rlankenau/thotcon0x6/README.md

thotcon0x6
==========

Thotcon 0x6 badge stuff.
