rlankenau/thotcon0x6/art/thotcon0x6.bmp

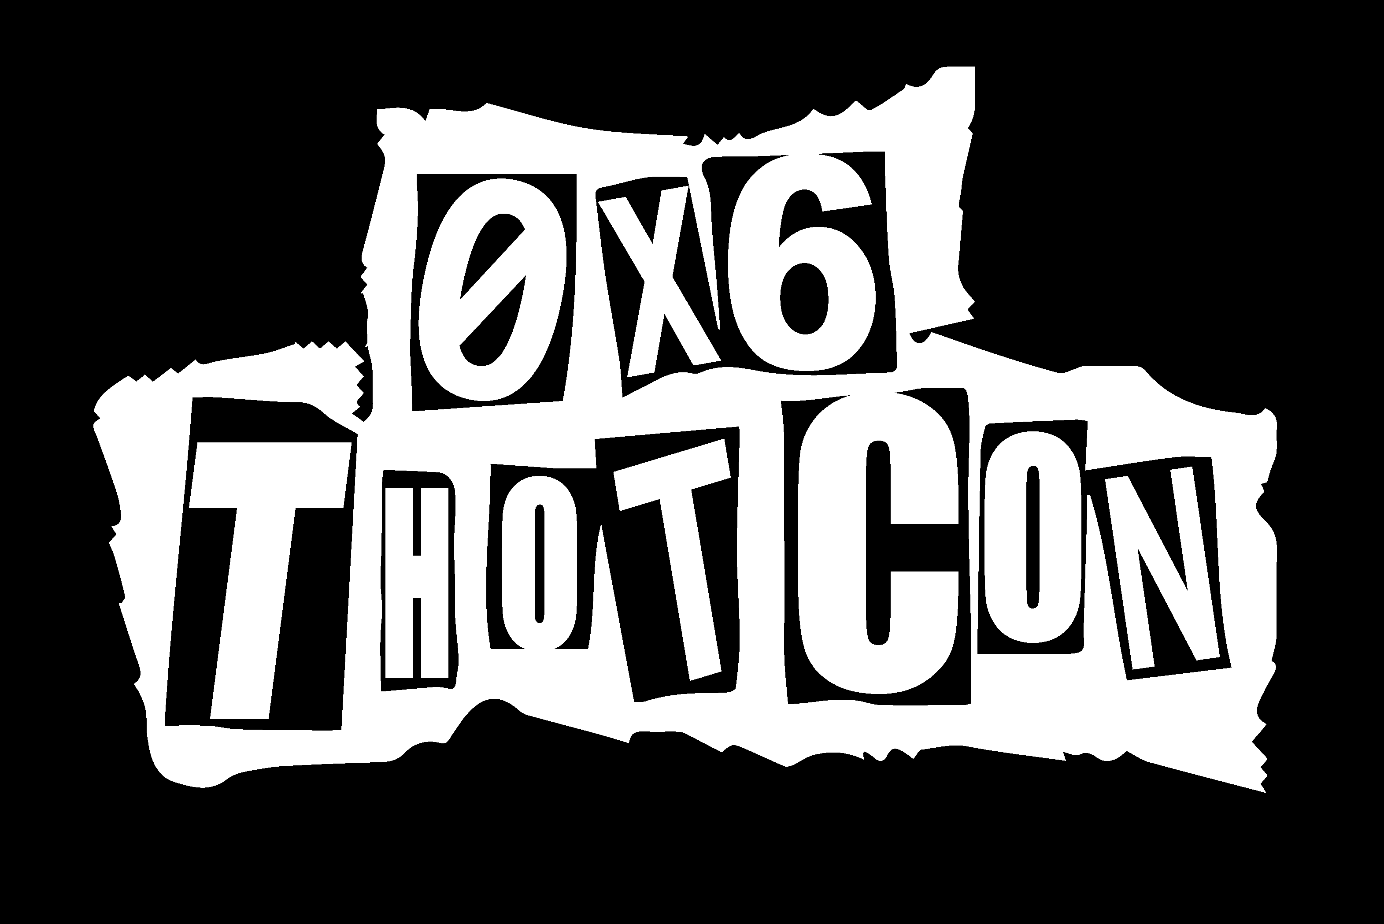
art/thotcon0x6.bmp
