rlankenau/thotcon0x6/art/THOTCON_0x6 - Torn Letter.bmp

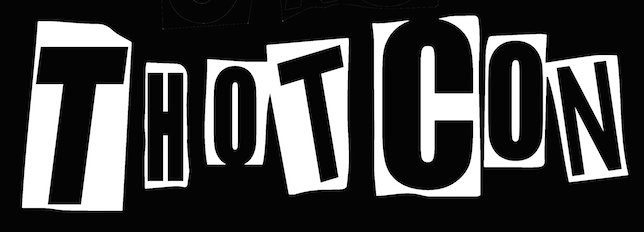
art/THOTCON_0x6 - Torn Letter.bmp
