rlankenau/thotcon0x6/hardware/schematics/temp.png

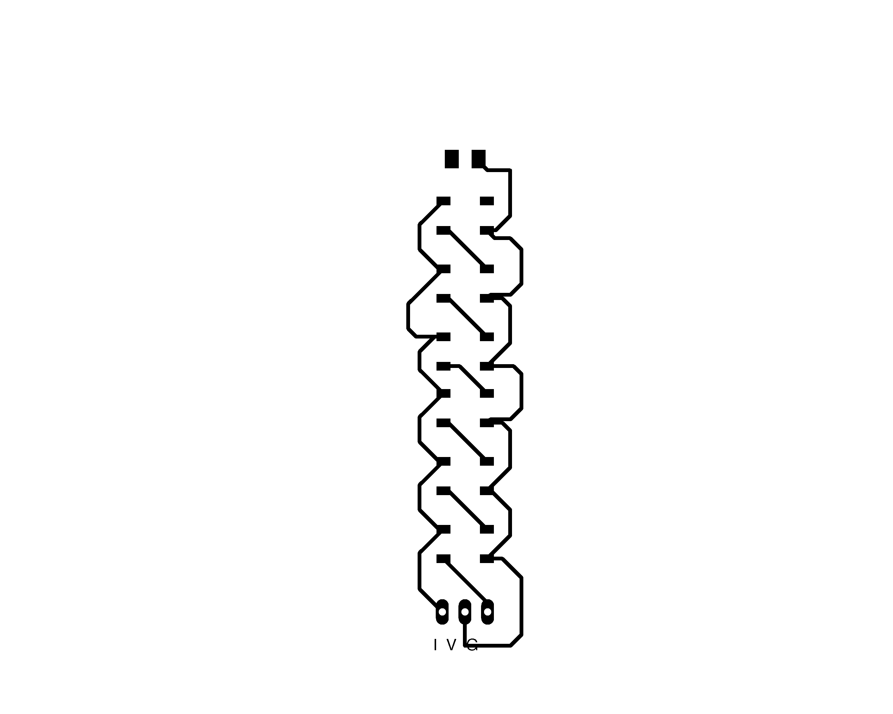
hardware/schematics/temp.png
