rlankenau/thotcon0x6/hardware/stencil/stencil.png

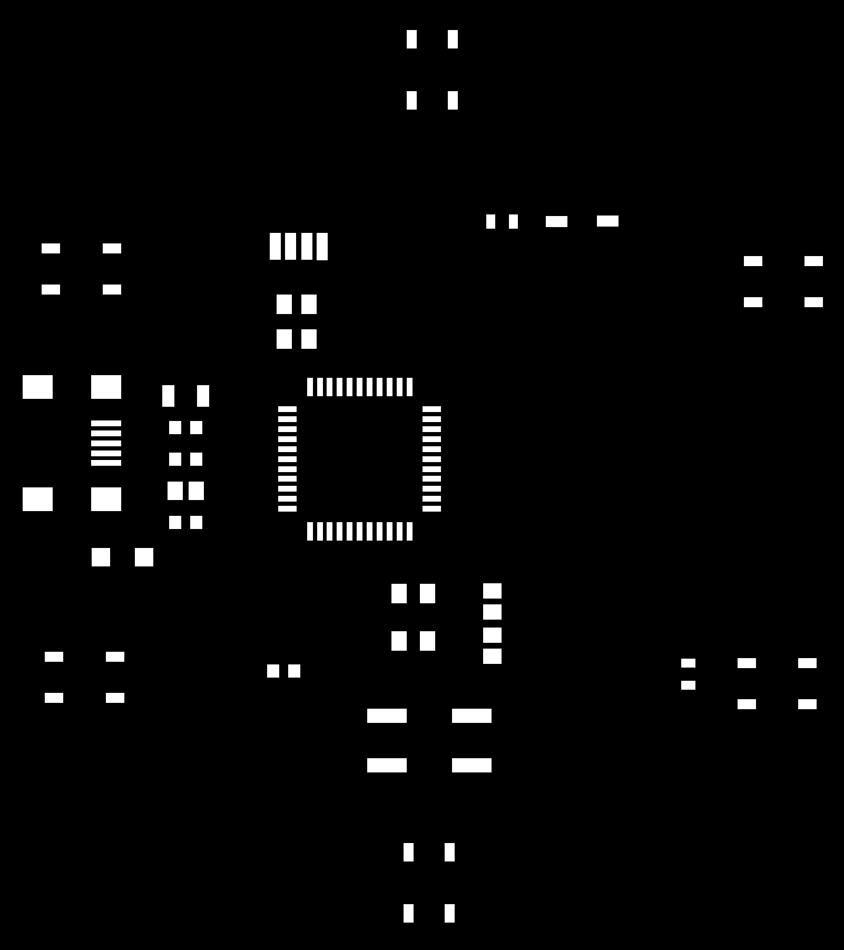
hardware/stencil/stencil.png
