rlankenau/thotcon0x6/hardware/tc-proto.png

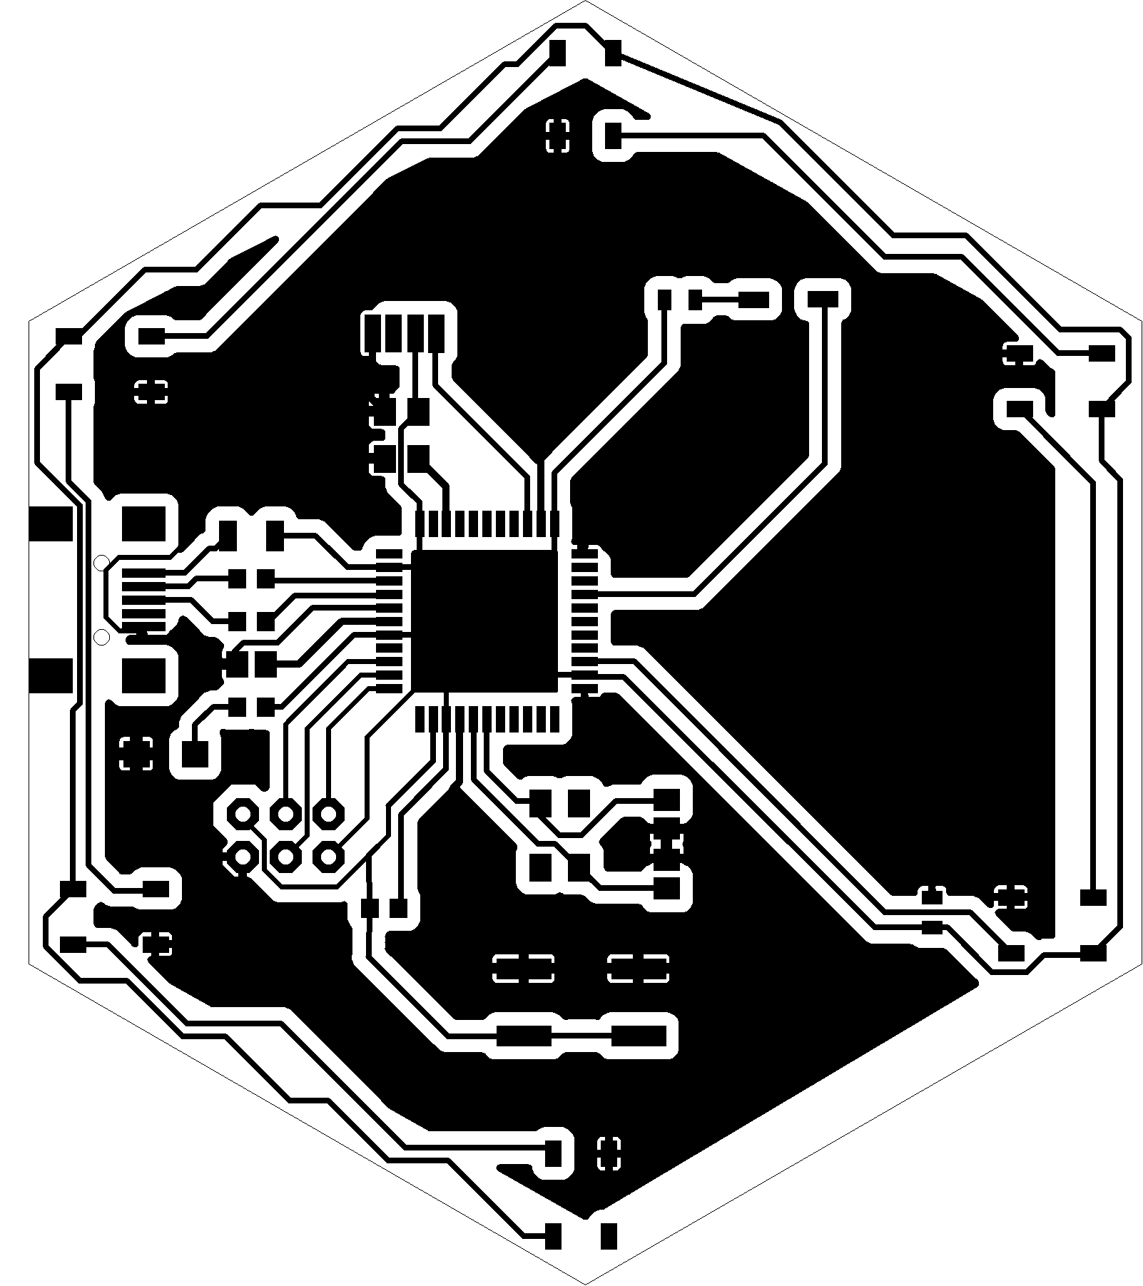
hardware/tc-proto.png
