rlankenau/thotcon0x6/BoM/THOTCON-0x6-PROTO-BoM.xls

THOTCON0x6-PROTO
Supplier SKU# | Mfr. # | Manufacturer | Desc. | RoHS | Lifecycle | Customer Part # | Order Qty. | Price (USD)
720-LGN971-KN-1 | LG N971-KN-1 | Osram Opto Semiconductor | Standard LEDs - SMD Green, 570nm 45mcd, 20mA | RoHS Compliant |  |  | 1 | $0.09
667-EVQ-Q2P02W | EVQ-Q2P02W | Panasonic | Tactile Switches 1.6NF 6.5x6.0x2.5mm | RoHS Compliant |  |  | 1 | $0.273
712-BAT-HLD-001-THM | BAT-HLD-001-THM | Linx Technologies | Coin Cell Battery Holders Bat Hld CR2032/2025 Through-hole Mount | RoHS Compliant |  |  | 1 | $0.28
576-1206L050/15YR | 1206L050/15YR | Littelfuse | Resettable Fuses - PPTC 15V 1206 .500A POLYFUSE | RoHS Compliant |  |  | 1 | $0.381
538-67503-1020 | 67503-1020 | Molex | USB Connectors USB Mini-B Recept On-The-Go Rt.Angle | RoHS Compliant |  |  | 1 | $0.992
594-MCT06030C2209FP5 | MCT06030C2209FP500 | Vishay | Thin Film Resistors - SMD .1W 22ohm 1% 0603 50ppm Auto | RoHS Compliant | New At Mouser |  | 2 | $0.06
71-CRCW0603-10K-E3 | CRCW060310K0FKEA | Vishay | Thick Film Resistors - SMD 1/10watt 10Kohms 1% | RoHS Compliant By Exemption |  |  | 1 | $0.013
78-TSML1020 | TSML1020 | Vishay | Infrared Emitters 12 Degree 190mW | RoHS Compliant |  |  | 1 | $0.60
140-VE100M1CTR0405 | VE-100M1CTR-0405 | Lelon | Aluminum Electrolytic Capacitors - SMD 16 Volts 10uF 20% 4x5.3 | RoHS Compliant |  |  | 1 | $0.12
81-GRM219R61H105KA3D | GRM219R61H105KA73D | Murata | Multilayer Ceramic Capacitors MLCC - SMD/SMT 0805 1uF 50volts X5R 10% | RoHS Compliant | New Product |  | 1 | $0.10
77-VJ0805Y104MXXAC | VJ0805Y104MXXAC | Vishay | Multilayer Ceramic Capacitors MLCC - SMD/SMT .1uF 25volts X7R 20% | RoHS Compliant |  |  | 4 | $0.06
556-ATMEGA32U4-AU | ATMEGA32U4-AU | Atmel | 8-bit Microcontrollers - MCU AVR USB 32K FLASH INDUSTRIAL | RoHS Compliant |  |  | 1 | $5.74
77-VJ0805A180GXXCBC | VJ0805A180GXXCW1BC | Vishay | Multilayer Ceramic Capacitors MLCC - SMD/SMT 0805 18pF 25volts C0G 2% | RoHS Compliant |  |  | 2 | $0.06
782-TSOP36236TT | TSOP36236TT | Vishay | Infrared Receivers 2.7-5.5V 36kHz 45Deg | RoHS Compliant |  |  | 1 | $1.48
ADA-1655 | WS2128B | Worldsemi | Intelligent Control LED Integrated Light Source | RoHS Compliant |  |  | 6 | $0.45
