rlankenau/thotcon0x6/art/hexagon.dxf

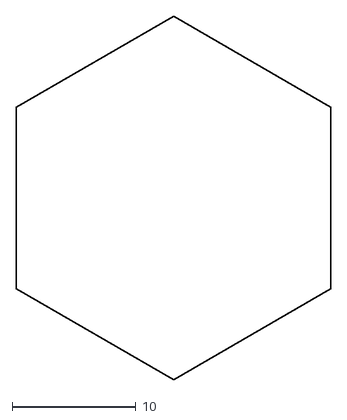
[picture p6: CAD file, 2015-03-03]
art/hexagon.dxf
25.4 x 29.3
