rlankenau/thotcon0x6/hardware/hexagon.dxf

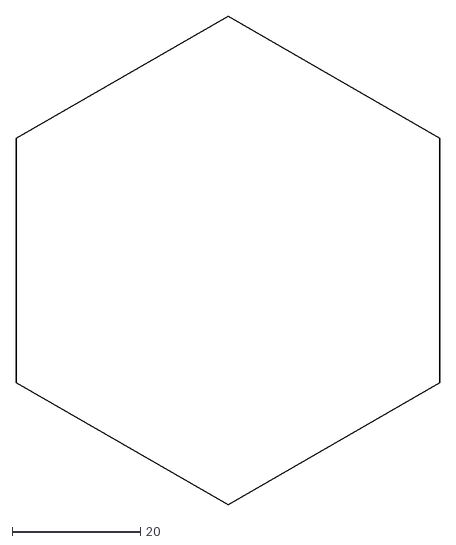
[picture p7: CAD file, 2015-03-09]
hardware/hexagon.dxf
66.0 x 76.2
