rlankenau/thotcon0x6/hardware/hexagon.scad

$fn = 150 ;			// OpenSCAD Resolution


projection(cut = true) Hexagon(cle=25.4,h=1);


module Hexagon(cle,h)
{
	angle = 360/6;		// 6 pans
	cote = cle * cot(angle);
	echo(angle, cot(angle), cote);
	echo(acos(.6));

	union()
	{
		rotate([0,0,0])
			cube([cle,cote,h],center=true);
		rotate([0,0,angle])
			cube([cle,cote,h],center=true);
		rotate([0,0,2*angle])
			cube([cle,cote,h],center=true);
	}


}


function cot(x)=1/tan(x);

//==EOF=======================================================
