rlankenau/thotcon0x6/hardware/tc0x6proto1.pdf

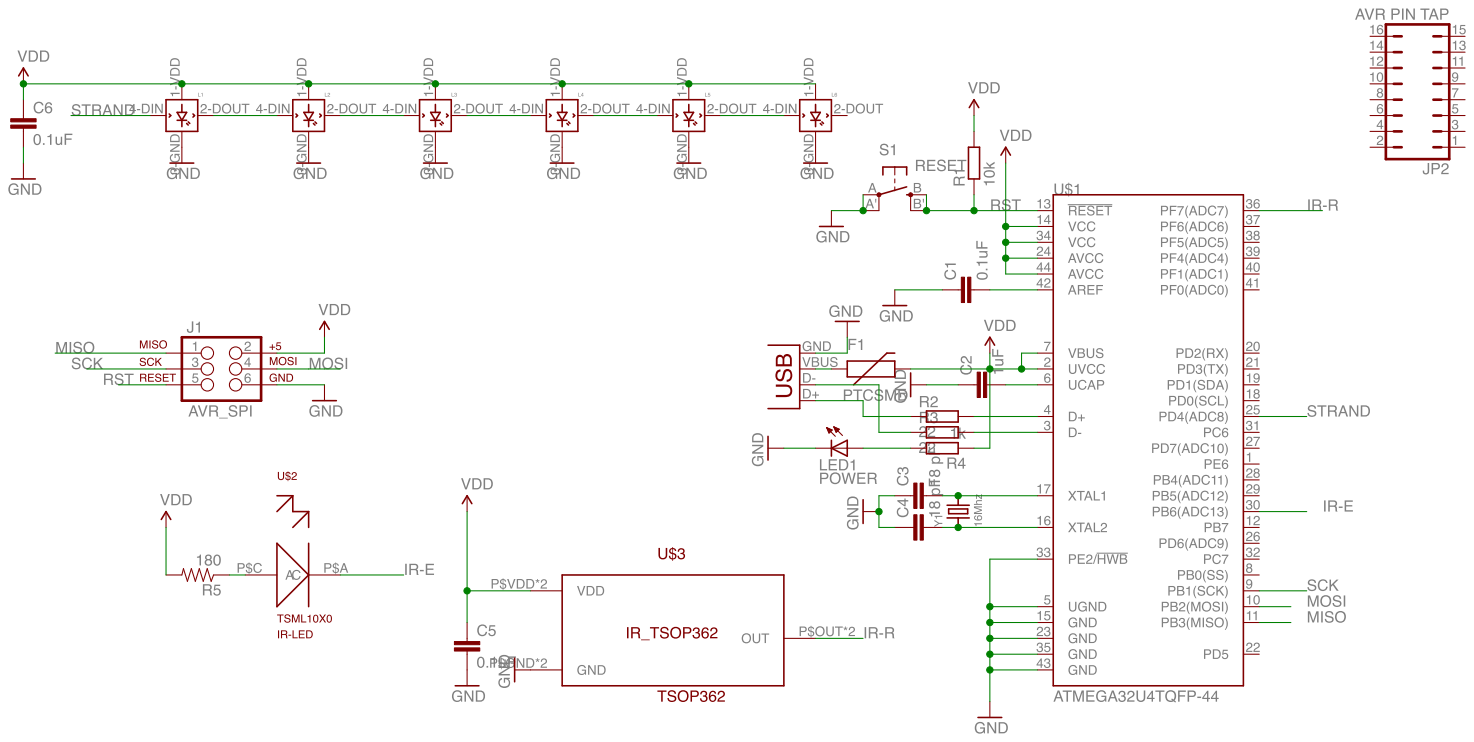
[picture p8: page 1]
