rlankenau/thotcon0x6/hardware/schematics/tc0x6proto1.brd

## EAGLE design hardware/schematics/tc0x6proto1.brd (2015-04-30)

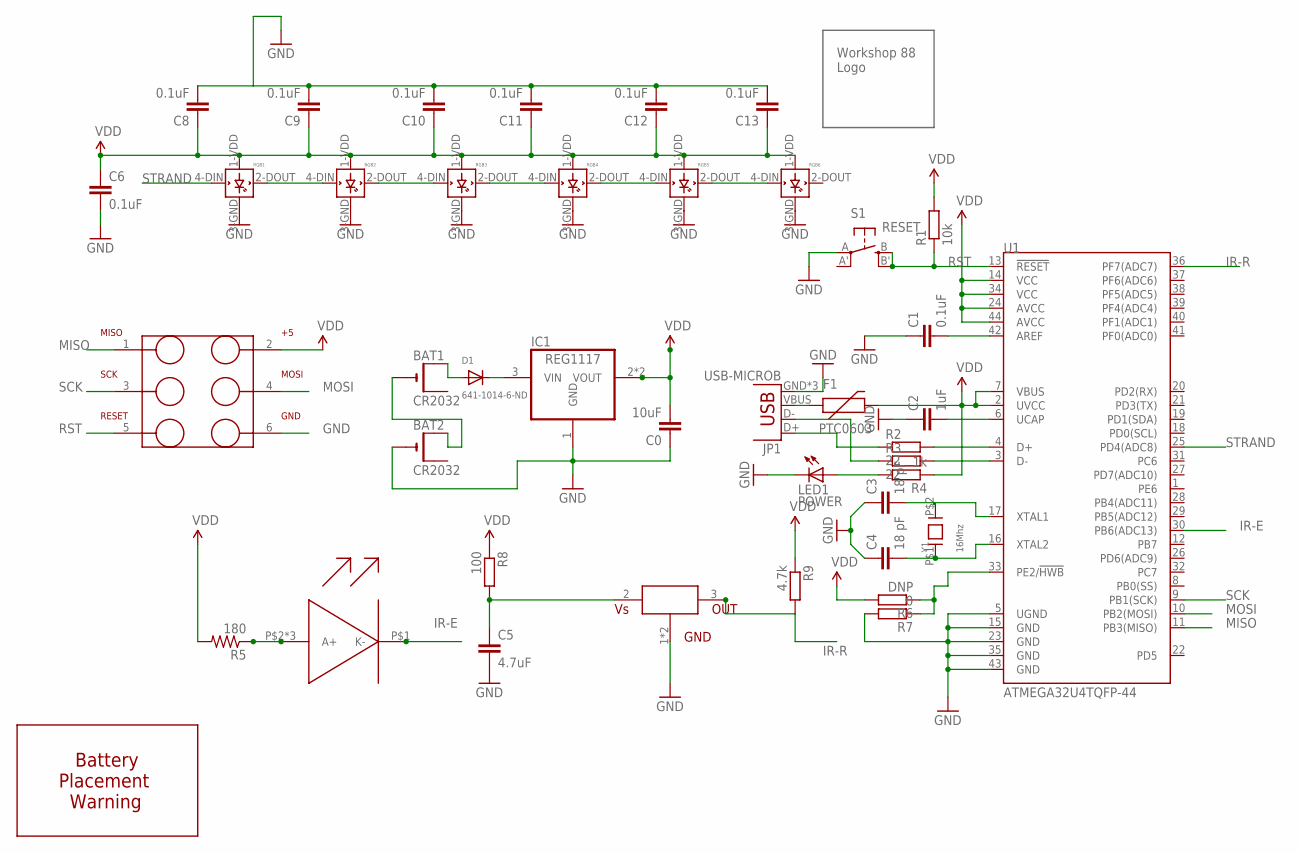
[picture p9: schematic tc0x6proto1.sch, THOTCON 0x6 Prototype]

Parts:
BAT1, BAT2: CR2032; CR2032-SMD
C0: 10uF; C0603
C1, C8, C9, C10, C11, C12, C13: 0.1uF; C0603
C2: 1uF; C0603
C3, C4: 18 pF; C0603
C5: 4.7uF; C0603
C6: 0.1uF; 0603-CAP
D1: 641-1014-6-ND; SMADIODE
F1: PTC0603; 0603
IC1: REG1117; SOT223
JP1: USB-MICROB
LED1: POWER; CHIPLED_1206
R1: 10k; R0603
R2, R3: 22; R0603
R4: 1k; R0603
R5: 180; 0603-RES
R6: DNP; R0603
R7: 0; R0603
R8: 100; R0603
R9: 4.7k; R0603
RGB1, RGB2, RGB3, RGB4, RGB5, RGB6: WS2812B
S1: RESET; EVQ-Q2
U1: ATMEGA32U4TQFP-44; TQFP44
U2: TSMP77000; TSMP77000TT
U3: SFH4259S; POWER_TOPLED_WITH_LENS
U$1: W88LOGO; W88-LOGO
U$4: AVR-TAG-CONNECTSNAP-ON; TC2030-MCP
U$5: BATTERY_WARNING; BATTERY_PLACEMENT_WARN
Y1: 16Mhz; SMD5MMX3.2MM

Connections:
BAT_BAT: BAT1.-, BAT2.+$1 (+)
GND: BAT2.-, C0.1, C1.1, C2.1, C3.1, C4.1, C5.2, C6.2, C8.2, C9.2, C10.2, C11.2, C12.2, C13.2, IC1.1 (GND), JP1.GND, JP1.MT1 (GND), JP1.MT2 (GND), LED1.C, R7.2, RGB1.3-GND (GND), RGB2.3-GND (GND), RGB3.3-GND (GND), RGB4.3-GND (GND), RGB5.3-GND (GND), RGB6.3-GND (GND), S1.A, U1.5 (UGND), U1.15 (GND), U1.23 (GND), U1.35 (GND), U1.43 (GND), U2.1 (GND), U2.4 (GND), U$4.6 (GND)
IR-E: U1.30 (PB6(ADC13)), U3.P$1 (K-)
IR-R: R9.2, U1.36 (PF7(ADC7)), U2.3 (OUT)
MISO: U1.11 (PB3(MISO)), U$4.1 (MISO)
MOSI: U1.10 (PB2(MOSI)), U$4.4 (MOSI)
unnamed: C5.1, R8.2, U2.2 (VDD)
unnamed: R3.2, U1.3 (D-)
unnamed: R6.1, R7.1, U1.33 (PE2/!HWB)
unnamed: JP1.D+, R2.1
unnamed: C1.2, U1.42 (AREF)
unnamed: R2.2, U1.4 (D+)
unnamed: JP1.D-, R3.1
unnamed: LED1.A, R4.2
unnamed: C2.2, U1.6 (UCAP)
unnamed: C3.2, U1.17 (XTAL1), Y1.P$2 (2)
unnamed: C4.2, U1.16 (XTAL2), Y1.P$1 (1)
unnamed: R5.1, U3.P$2 (A+), U3.P$3 (A+), U3.P$4 (A+)
unnamed: F1.1, JP1.VBUS
RST: R1.1, S1.B (S), S1.B' (S1), U1.13 (!RESET), U$4.5 (RESET)
SCK: U1.9 (PB1(SCK)), U$4.3 (SCK)
STRAND: RGB1.4-DIN (DIN), U1.25 (PD4(ADC8))
STRAND_1_2: RGB1.2-DOUT (DOUT), RGB2.4-DIN (DIN)
STRAND_2_3: RGB2.2-DOUT (DOUT), RGB3.4-DIN (DIN)
STRAND_3_4: RGB3.2-DOUT (DOUT), RGB4.4-DIN (DIN)
STRAND_4_5: RGB4.2-DOUT (DOUT), RGB5.4-DIN (DIN)
STRAND_5_6: RGB5.2-DOUT (DOUT), RGB6.4-DIN (DIN)
VBAT: BAT1.+$1 (+), D1.A
VBAT_RECT: D1.C, IC1.3 (VIN)
VDD: C0.2, C6.1, C8.1, C9.1, C10.1, C11.1, C12.1, C13.1, F1.2, IC1.2 (VOUT), IC1.4 (VOUT), R1.2, R4.1, R5.2, R6.2, R8.1, R9.1, RGB1.1-VDD (VDD), RGB2.1-VDD (VDD), RGB3.1-VDD (VDD), RGB4.1-VDD (VDD), RGB5.1-VDD (VDD), RGB6.1-VDD (VDD), U1.2 (UVCC), U1.7 (VBUS), U1.14 (VCC), U1.24 (AVCC), U1.34 (VCC), U1.44 (AVCC), U$4.2 (VCC)

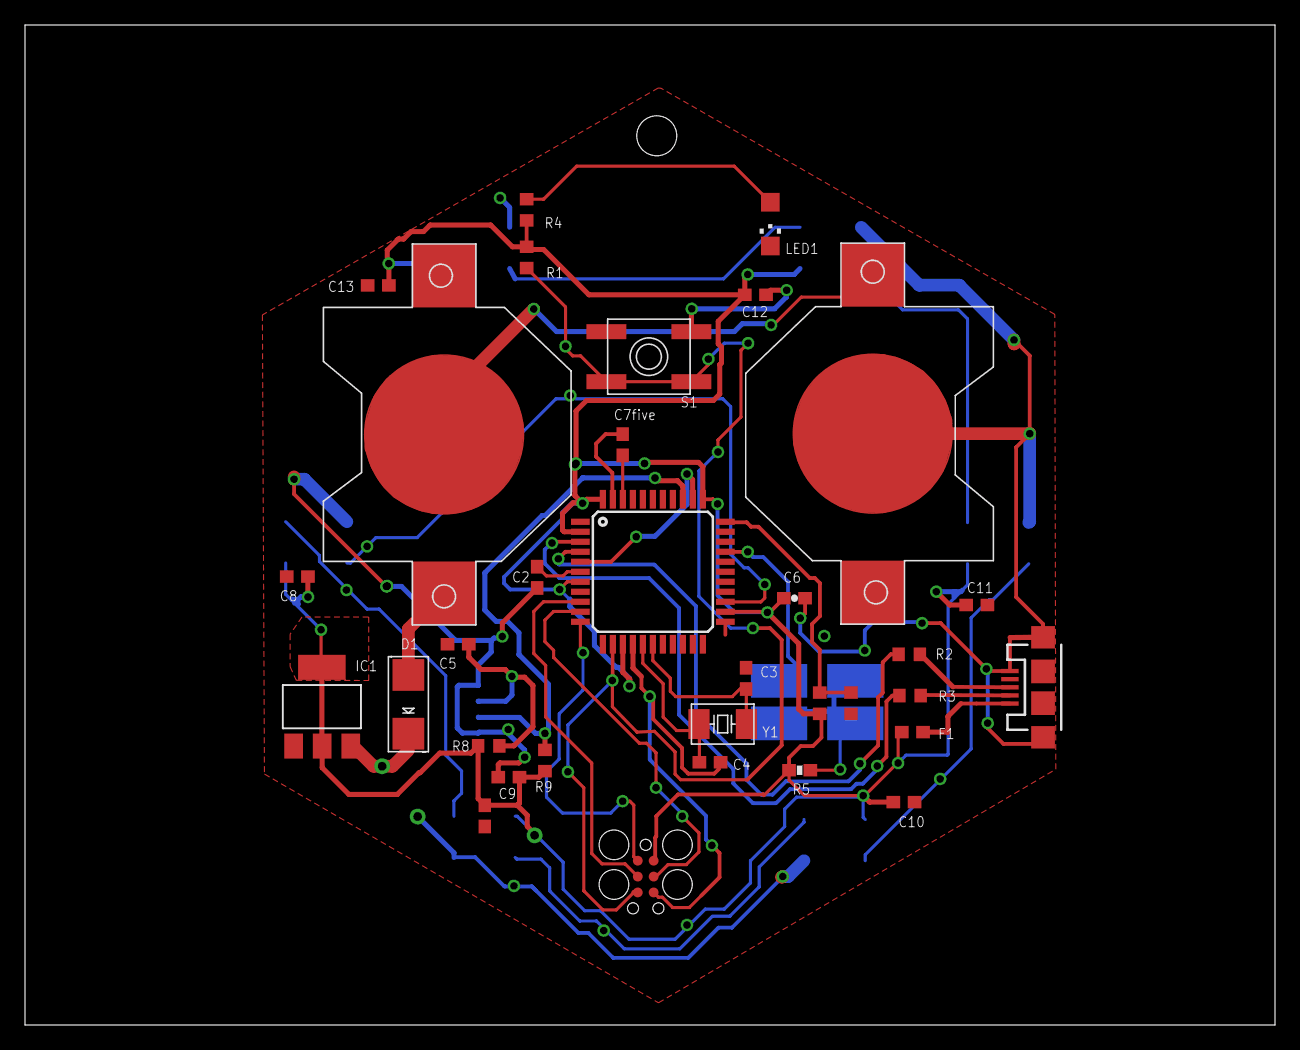
[picture p10: board hardware/schematics/tc0x6proto1.brd from above]

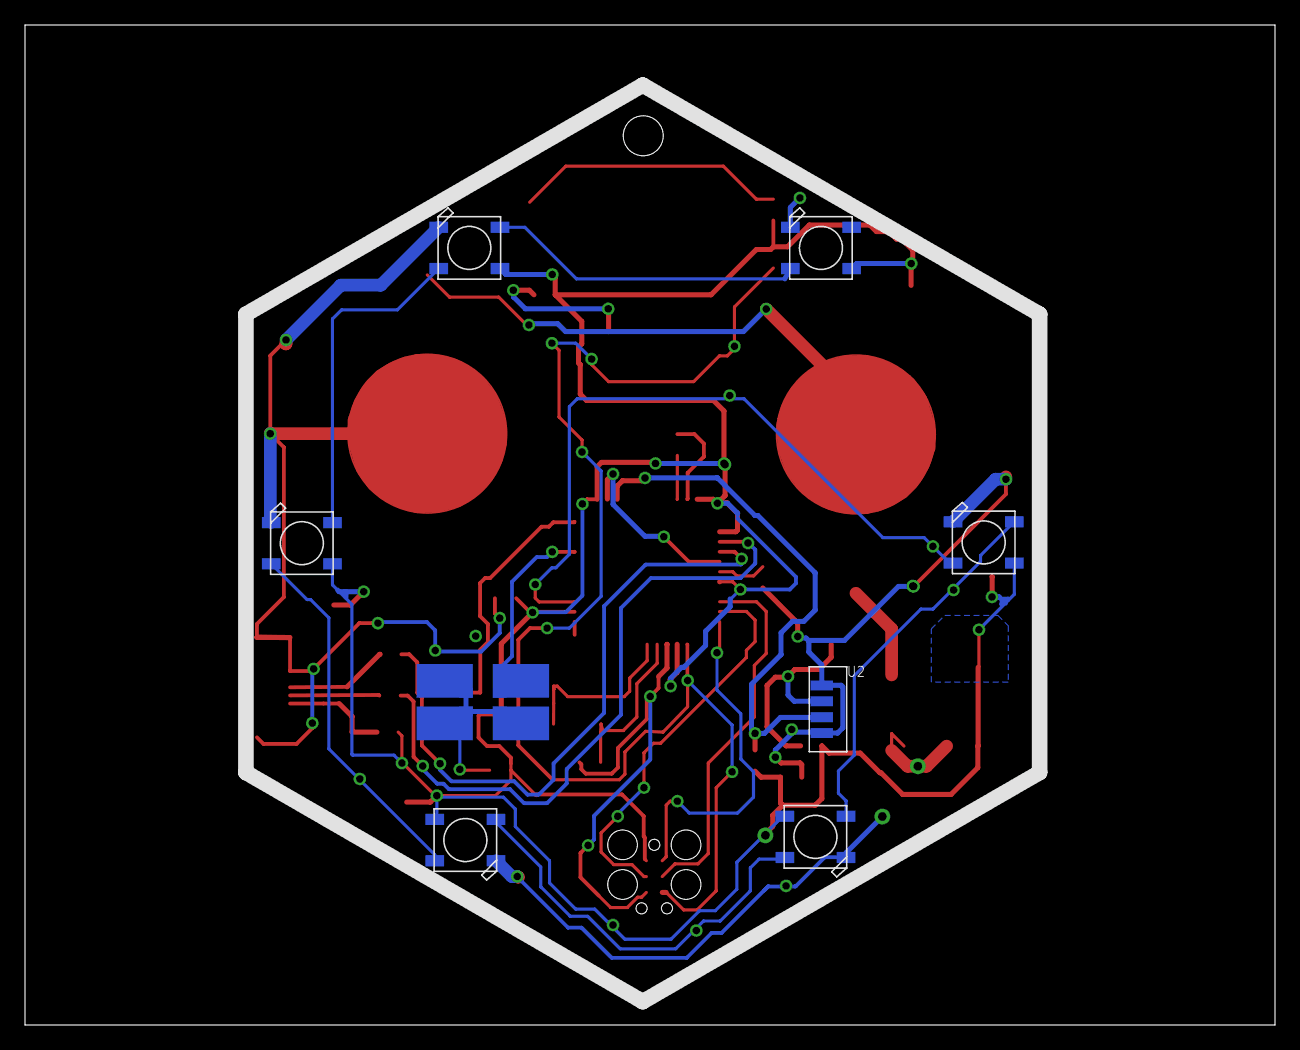
[picture p11: board hardware/schematics/tc0x6proto1.brd from below]

Board: 2 copper layers, 100.0 x 80.0 mm, 43 parts (8 on the bottom side), 30 nets.
