rlankenau/thotcon0x6/hardware/boards/tc0x6breakout.brd

## EAGLE design hardware/boards/tc0x6breakout.brd (2015-03-09)

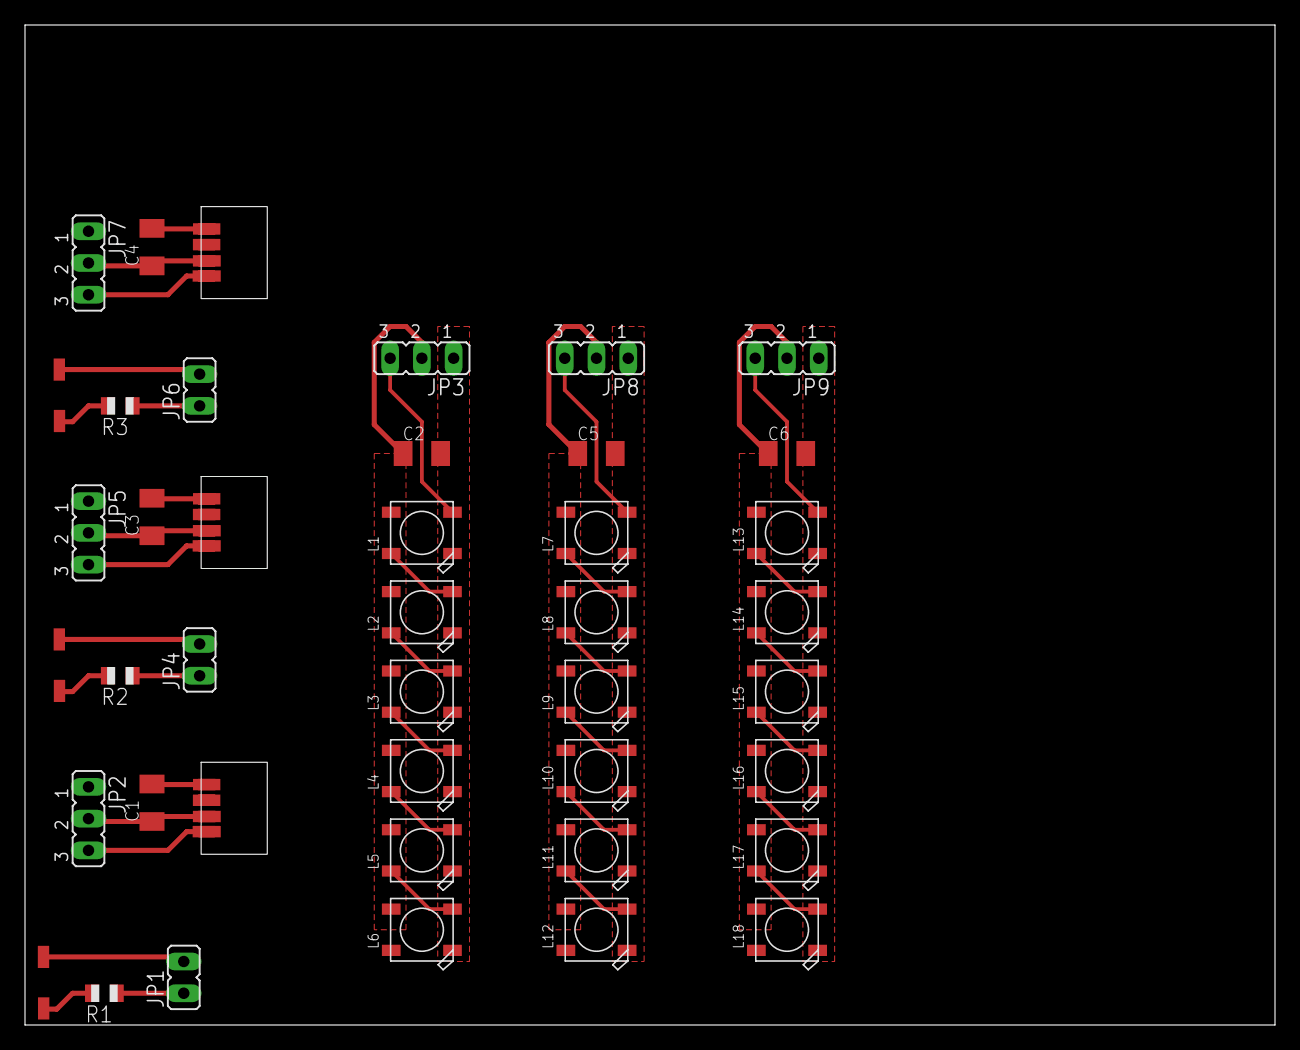
[picture p12: board tc0x6breakout.brd from above]

Board: 2 copper layers, 100.0 x 80.0 mm, 42 parts (0 on the bottom side), 42 nets.

Parts:
C1, C2, C3, C4, C5, C6: C1206K
JP1, JP4, JP6: V O; JP1
JP2, JP5, JP7: O V G; JP2
JP3, JP8, JP9: I V G; JP2
L1, L2, L3, L4, L5, L6, L7, L8, L9, L10, L11, L12, L13, L14, L15, L16, L17, L18: WS2812B
R1, R2, R3: 150; R0805
U$1, U$3, U$5: TSML10X0; TSML10X0SMD
U$2, U$4, U$6: TSOP362; TSOP362SMD

Connections:
DIO: JP3.3, L1.4-DIN
DIO1: JP8.3, L7.4-DIN
DIO2: JP9.3, L13.4-DIN
GND: C2.2, JP3.1, L1.3-GND, L2.3-GND, L3.3-GND, L4.3-GND, L5.3-GND, L6.3-GND
GND1: C5.2, JP8.1, L7.3-GND, L8.3-GND, L9.3-GND, L10.3-GND, L11.3-GND, L12.3-GND
GND2: C6.2, JP9.1, L13.3-GND, L14.3-GND, L15.3-GND, L16.3-GND, L17.3-GND, L18.3-GND
unnamed: JP1.1, R1.1
unnamed: JP1.2, U$1.P$A
unnamed: R1.2, U$1.P$C
unnamed: C1.1, JP2.2, U$2.P$VDD, U$2.P$VDD2
unnamed: C1.2, JP2.1, U$2.P$GND, U$2.P$GND2
unnamed: L2.2-DOUT, L3.4-DIN
unnamed: JP2.3, U$2.P$OUT, U$2.P$OUT2
unnamed: L3.2-DOUT, L4.4-DIN
unnamed: L4.2-DOUT, L5.4-DIN
unnamed: L1.2-DOUT, L2.4-DIN
unnamed: L5.2-DOUT, L6.4-DIN
unnamed: JP4.1, R2.1
unnamed: JP4.2, U$3.P$A
unnamed: R2.2, U$3.P$C
unnamed: C3.1, JP5.2, U$4.P$VDD, U$4.P$VDD2
unnamed: C3.2, JP5.1, U$4.P$GND, U$4.P$GND2
unnamed: JP5.3, U$4.P$OUT, U$4.P$OUT2
unnamed: JP6.1, R3.1
unnamed: JP6.2, U$5.P$A
unnamed: R3.2, U$5.P$C
unnamed: C4.1, JP7.2, U$6.P$VDD, U$6.P$VDD2
unnamed: C4.2, JP7.1, U$6.P$GND, U$6.P$GND2
unnamed: JP7.3, U$6.P$OUT, U$6.P$OUT2
unnamed: L7.2-DOUT, L8.4-DIN
unnamed: L8.2-DOUT, L9.4-DIN
unnamed: L9.2-DOUT, L10.4-DIN
unnamed: L11.2-DOUT, L12.4-DIN
unnamed: L10.2-DOUT, L11.4-DIN
unnamed: L13.2-DOUT, L14.4-DIN
unnamed: L14.2-DOUT, L15.4-DIN
unnamed: L15.2-DOUT, L16.4-DIN
unnamed: L17.2-DOUT, L18.4-DIN
unnamed: L16.2-DOUT, L17.4-DIN
VDD: C2.1, JP3.2, L1.1-VDD, L2.1-VDD, L3.1-VDD, L4.1-VDD, L5.1-VDD, L6.1-VDD
VDD1: C5.1, JP8.2, L7.1-VDD, L8.1-VDD, L9.1-VDD, L10.1-VDD, L11.1-VDD, L12.1-VDD
VDD2: C6.1, JP9.2, L13.1-VDD, L14.1-VDD, L15.1-VDD, L16.1-VDD, L17.1-VDD, L18.1-VDD
