rlankenau/thotcon0x6/hardware/boards/tc0x6proto1.brd

## EAGLE design hardware/boards/tc0x6proto1.brd (2015-03-09)

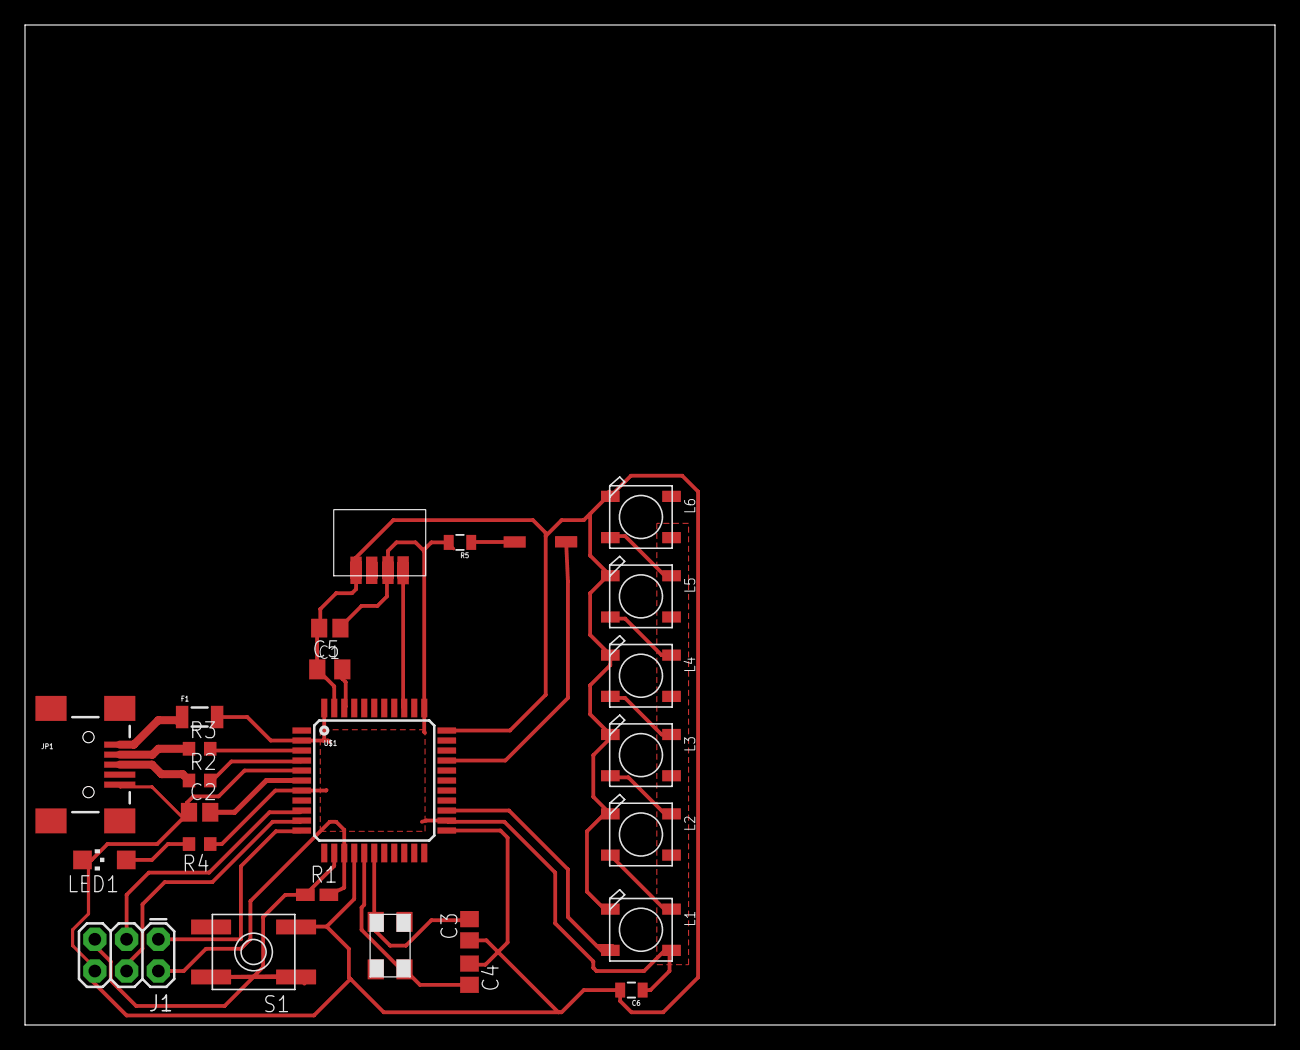
[picture p13: board hardware/boards/tc0x6proto1.brd from above]

Board: 2 copper layers, 100.0 x 80.0 mm, 26 parts (0 on the bottom side), 25 nets.

Parts:
C1: 0.1uF; C0805K
C2: 1uF; C0805
C3, C4: 18 pF; C0805
C5: 0.1uF; C0805
C6: 0.1uF; 0805
F1: PTCSMD; PTC-1206
J1: AVR_SPI; 2X3
JP1: USBSMD; USB-MINIB
L1, L2, L3, L4, L5, L6: WS2812B
LED1: POWER; CHIPLED_1206
R1: 10k; R0805W
R2, R3: 22; R0603
R4: 1k; R0603
R5: 180; 0805
S1: RESET; EVQ-Q2
U$1: ATMEGA32U4TQFP-44; TQFP44
U$2: TSML10X0; TSML10X0SMD
U$3: TSOP362; TSOP362SMD
Y1: 16Mhz; 5X3.2MM

Connections:
GND: C1.1, C2.1, C3.1, C4.1, C5.2, C6.2, J1.6, JP1.GND, L1.3-GND, L2.3-GND, L3.3-GND, L4.3-GND, L5.3-GND, L6.3-GND, LED1.C, S1.A, U$1.5, U$1.15, U$1.23, U$1.33, U$1.35, U$1.43, U$3.P$GND, U$3.P$GND2
IR-E: U$1.30, U$2.P$A
IR-R: U$1.36, U$3.P$OUT, U$3.P$OUT2
MISO: J1.1, U$1.11
MOSI: J1.4, U$1.10
unnamed: R3.2, U$1.3
unnamed: L1.2-DOUT, L2.4-DIN
unnamed: L2.2-DOUT, L3.4-DIN
unnamed: L3.2-DOUT, L4.4-DIN
unnamed: L4.2-DOUT, L5.4-DIN
unnamed: L5.2-DOUT, L6.4-DIN
unnamed: JP1.D+, R2.1
unnamed: C1.2, U$1.42
unnamed: R2.2, U$1.4
unnamed: JP1.D-, R3.1
unnamed: LED1.A, R4.2
unnamed: C2.2, U$1.6
unnamed: C3.2, U$1.17, Y1.3
unnamed: C4.2, U$1.16, Y1.1
unnamed: R5.1, U$2.P$C
unnamed: F1.1, JP1.VBUS
RST: J1.5, R1.1, S1.B, S1.B', U$1.13
SCK: J1.3, U$1.9
STRAND: L1.4-DIN, U$1.25
VDD: C5.1, C6.1, F1.2, J1.2, L1.1-VDD, L2.1-VDD, L3.1-VDD, L4.1-VDD, L5.1-VDD, L6.1-VDD, R1.2, R4.1, R5.2, U$1.2, U$1.7, U$1.14, U$1.24, U$1.34, U$1.44, U$3.P$VDD, U$3.P$VDD2
