rlankenau/thotcon0x6/code/IR_shark_basic/IR_shark_basic.ino

#include <IRLib.h>

int RECV_PIN = A0;

IRrecv My_Receiver(RECV_PIN);
IRdecode My_Decoder;
IRsend My_Sender;
/*
 * Because this version of the library separated the receiver from the decoder,
 * technically you would not need to "store" the code outside the decoder object
 * for this overly simple example. All of the details would remain in the object.
 * However we are going to go ahead and store them just to show you how.
 */
// Storage for the recorded code
IRTYPES codeType;          // The type of code
unsigned long codeValue;   // The data bits if type is not raw
int codeBits;              // The length of the code in bits

// These values are only stored if it's an unknown type and we are going to use
// raw codes to resend the information.
unsigned int rawCodes[RAWBUF]; // The durations if raw
int rawCount;                   //The number of interval samples

bool GotOne, GotNew; 

void setup()
{
  GotOne=false; GotNew=false;
  codeType=UNKNOWN; 
  codeValue=0; 
  Serial.begin(9600);
  delay(2000);while(!Serial);//delay for Leonardo
  Serial.println(F("Send a code from your remote and we will record it."));
  Serial.println(F("Type any character and press enter. We will send the recorded code."));
  My_Receiver.enableIRIn(); // Start the receiver
}

// Stores the code for later playback
void storeCode(void) {
  GotNew=true;
  codeType = My_Decoder.decode_type;
  if (codeType == UNKNOWN) {
    Serial.println("Received unknown code, saving as raw");
    // To store raw codes:
    // Drop first value (gap)
    // As of v1.3 of IRLib global values are already in microseconds rather than ticks
    // They have also been adjusted for overreporting/underreporting of marks and spaces
    rawCount = My_Decoder.rawlen-1;
    for (int i = 1; i <=rawCount; i++) {
      rawCodes[i - 1] = My_Decoder.rawbuf[i];
    };
    My_Decoder.DumpResults();
    codeType=UNKNOWN;
  }
  else {
    Serial.print(F("Received "));
    Serial.print(Pnames(codeType));
    if (My_Decoder.value == REPEAT) {
      // Don't record a NEC repeat value as that's useless.
      Serial.println(F("repeat; ignoring."));
     }
     else {
       codeValue = My_Decoder.value;
       codeBits = My_Decoder.bits;
     }
     Serial.print(F(" Value:0x"));
     Serial.println(My_Decoder.value, HEX);
  }
}
void sendCode(int repeat) {
  if(codeType== UNKNOWN) {
    // Assume 38 KHz
    My_Sender.IRsendRaw::send(rawCodes,rawCount,38);
    Serial.println(F("Sent raw"));
    return;
  }
  if( !GotNew ) {//We've already sent this so handle toggle bits
    if (codeType == RC5) {
      codeValue ^= 0x0800;
    }
    else if (codeType == RC6) {
      codeValue ^= 0x10000;
    }
  }
  GotNew=false;
  My_Sender.send(codeType,codeValue,codeBits);
  Serial.print(F("Sent "));
  Serial.print(Pnames(codeType));
  Serial.print(F(" Value:0x"));
  Serial.println(codeValue, HEX);
}

void loop() {
  if (Serial.read() != -1) {
    if(GotOne) {
      sendCode(0);
      My_Receiver.enableIRIn(); // Re-enable receiver
    }
  } 
  else if (My_Receiver.GetResults(&My_Decoder)) {
    My_Decoder.decode();
    GotOne=true;
    storeCode();
    delay(1000);
    My_Receiver.resume(); 
  }
}
