rlankenau/thotcon0x6/(commit log)

2015-03-03 initial push from Rudy
    hardware work to date, working BoM, single side eagles, art, datasheets
    and a little code
    [THOTCON-0x6-PROTO-BoM.xls, hexagon.dxf, hexagon.scad]
2015-03-09 hardware updates
    eagles and negatives
    [hexagon.dxf, tc0x6breakout.brd, tc0x6breakout.sch, tc0x6hexproto.sch, tc0x6proto1.brd, tc0x6proto1.sch]
2015-03-10 stencil files
    various files for etching solder mask stencils
2015-03-24 Updated prototype with art, LDO, and batteries.
    [tc0x6proto1.brd, tc0x6proto1.sch]
2015-03-24 Added gerbers for prototype review.
    [THOTCON0x6-proto.GBL, THOTCON0x6-proto.GBO, THOTCON0x6-proto.GBS, THOTCON0x6-proto.GTL, THOTCON0x6-proto.GTO, THOTCON0x6-proto.GTP, THOTCON0x6-proto.GTS]
2015-03-25 Fixed incorrect layout for voltage regulator, changed to 0603 packaging
    [tc0x6proto1.brd, tc0x6proto1.sch]
2015-03-26 Updated board with tag connect and ground pour. Battery holders still need to be changed out for better parts.
    [tc0x6proto1.brd, tc0x6proto1.sch]
2015-04-02 Added diode, fixed battery hookup direction, added battery warning.
    [tc0x6proto1.brd, tc0x6proto1.sch]
2015-04-06 Modified bottom silk. Added gerbers for initial quote.
    [tc0x6proto1.brd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]
2015-04-07 Updated board with TSMP77000 rather than TSOP362
    [tc0x6proto1.brd, tc0x6proto1.sch]
2015-04-22 Fixed font size, replaced xtal, cleaned up bottom ground trace.
    [tc0x6proto1.brd, tc0x6proto1.sch]
2015-04-23 Added jumper for USB boot select.
    [tc0x6proto1.brd, tc0x6proto1.sch]
2015-04-23 Moved power supply filter capacitor
    [tc0x6proto1.brd]
2015-04-28 Added LED caps
    [tc0x6proto1.brd, tc0x6proto1.sch]
2015-05-05 For programming over USB, the Arduino IDE opens and closes the serial port to force a reset. Unfortunately, this also causes the board to re-enumerate and possible get a new device. Added some script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
2015-05-06 Revert "boot sequence"
    This reverts commit 990b869b8c648723e8cab18e1544e45a2ad0623f.
    [strandtest_emitter.ino]
2015-05-06 switched to FastLED
    basic serial controlled dump of patterns WIP -R-
2015-05-07 Fix compiler errors from merge.
    [data.h, final.ino]
2015-05-10 fixed a few types to try to get the eeprom code working better.
    [final.ino]
2015-05-10 fixed some flow controll issues
    [bbs_interface.ino]
2015-05-10 Fixed ROOT pattern. Needed to cast 0xF8 to a char to prevent sign-extension during comparision
    [final.ino]
2015-05-10 Fixed display code and eeprom.
    [final.ino]
2015-05-10 Patch up merge problem
    [bbs_interface.ino]
2015-05-10 Integrated BBS and LED display
2015-05-12 disable safe mode in the USB burn because the fuses don't read correctly even though they're correct.
2015-05-12 Final stuff to burn
    [final.ino]
