rlankenau/thotcon0x6/(notices)

Notices in the files:
parts and their libraries:
SparkFun-DigitalIC: Licensing: Creative Commons ShareAlike 4.0 International - https://creativecommons.org/licenses/by-sa/4.0
w88: ©2009 ROFA.cz - modified and updated by Robert Darlington ‹rdarlington@gmail.com›
